milescook/bmwe30-speeduino/README.md

# About

This repo is a collection of diagrams, wiring plans and 3D printable models. The objective is converting a BMW E30 to use Speeduino with a digital dashboard using TS Dash. This uses the original Motronic 1.3 harness to de-risk the conversion.

Disclaimer: Anything you follow here is at your own risk.

Motronic Speeduino

## Wiring
The current running setup uses the stock Motronic 1.3 harness with targeted changes: a replacement injector sub-loom (later harnesses use a sub loom with a connector - see injector wiring for depin tool), TPS rewiring for an E36 variable TPS, AFM plug repurpose, and a relay/ignition module arrangement documented in this repo. I also converted the AFM plug to a generic connector though you could always make an adapter.

You can find a load of shorts and videos on progress here [https://www.youtube.com/cookracinguk](https://www.youtube.com/cookracinguk)

## Contents

These are the key items though take a look through the file list for bits and bobs. There is also an initial custom harness plan, but that is on hold and should be treated as reference only.

- [Motronic pins to Speeduino map](docs/motronic-speeduino-map.md)
- [Cluster Conversion](docs/cluster.md)
- [Speeduino engine data to AiM SOLO 2 DL over CAN](docs/aim-solo-can.md)
- [Ignition module](docs/ignition.md)
- [Intake wiring](docs/intake.md)
- [Injectors & wiring](docs/injector-wiring.md)
- [Main relay](docs/mainrelay.md)
- [TPS wiring](docs/tps.md)
- [Fuel level](docs/fuel-level.md)
- [Lambda](docs/lambda.md)
- [Useful links](docs/links.md)
