milescook/bmwe30-speeduino/docs/new-harness-plans/ecu-pinout.md

# ECU Pinout

Status: ON HOLD reference for a future custom harness. For the current running setup, use `../motronic-speeduino-map.md`.

* 34 pins on 4 rows, 9, 8, 9, 8. Pin number and wire colour (if present)

 [_1YE]  [_2BL]  [_3GR]  [_4WH]  [_5RD]  [_6BK]  [_7YE]  [_8BL]  [_9--]

*  [10--]  [11--]  [12BK]  [13RD]  [14--]  [15--]  [16YE]  [17BL]  
   
   [18--]  [19BL]  [20WH]  [21BL]  [22BK]  [23SG]  [24--]  [25SS]  

 [26RD] [27BK] [28--]  [29--]  [30GR]  [31RD]  [32WH]  [33GR]  [34WH]
  
## Key
* YE - Yellow
* BL - Blue
* GR - Green
* WH - White
* RD - Red
* BK - Black
* SG - Shielded ground
* SS - Shielded signal

## Pins
* 1 Injectors 1 & 6
* 2 Injectors 2 & 5
* 3 Injectors 3 & 4
* 4 Injectors 1 & 6
* 5 Injectors 2 & 5
* 6 Injectors 3 & 4
* 7 Coil packs 1 & 6
* 8 Ground (coolant, iat, lambda)
* 9 -
* 10 - 
* 11 -
* 12 - TPS Ground
* 13 - TPS Live
* 14 -
* 15 -
* 16 - Fuel pump relay
* 17 - Tacho out
* 18 -
* 19 - Coolant temp sensor
* 20 - Inlet temp sensor
* 21 - Lambda sensor
* 22 - TPS signal
* 23 - Crank position sensor ground
* 24 - CPS Shield ground
* 25 - Crank position sensor signal
* 26 - 12v Live
* 27 - 12v Ground
* 28 - 
* 29 - 
* 30 - Spare
* 31 - Oil pressure switch IN
* 32 - Oil pressure switch OUT dash
* 33 - Coil packs 3 & 4
* 34 - Coil packs 2 & 5
