milescook/bmwe30-speeduino/docs/lambda.md

# Lambda
- Car wiring colour - purpose - Motronic pin - Bespoke loom pin no. - Bespoke loom wire colour
- Black - Signal - Motronic pin 28 - 2 - Green
- White - Heater - Fuel pump live relay - 6 - Red
- Gray - Signal Ground - Motronic pin 10 - 5 - Black
- Gray - Heater Ground - ECU Loom ground - 3 - White

## Bespoke lambda loom

We need the ECU to accept the following wiring:

- Pin no. - Colour - Purpose - Connects to
- 1 - Blue - LED diagnostic - Direct to cluster
- 2 - Green - Signal - Car side green Motronic pin 28
- 3 - White - Heater ground - Car side Gray (chassis ground)
- 4 - Brown - Narrow band signal - unused
- 5 - Black - Signal ground - Car side Gray (O2 signal ground motronic pin 10)
- 6 - Red - Fused Live - Car side red

Temp harness
Blue - LED - N/A
red small - o2 sensor gnd - 1 motronic 10
White small - Signal live - 2 motronic 28
green large - fused live - 3 - motronic 23
Yellow - chassis GND - 4 - motronic n/a

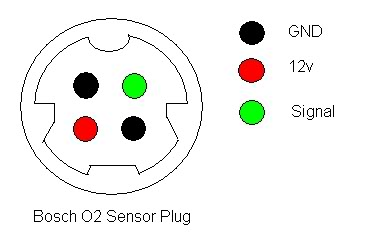
[picture p2: images/O2wiring.jpg]
Car Lambda Connector


# Harness side to o2 side
- Green to white
- Brown to white
- black to gray
- yellow to black
