milescook/bmwe30-speeduino/docs/fuel-level.md

# Fuel level via Speeduino analog input

The fuel sender feeds directly into IDC pin 15. TunerStudio reads it natively and TS Dash can display it as a gauge — no separate microcontroller needed.

## Sender range - readings at the original cluster

- `0 ohms` = full
- `60 ohms` = empty

BMW use a 68 ohm resistor in the cluster, so 128 ohms was empty.
After filling with 15L it read 98 ohms (then ran the engine 10 mins and read 106 — remember the swirl pot would have taken 1 litre).1

Maybe 20 ohms per 15L? I do have dents in my tank.

## Wiring

- Fuel sender one side - White plug pin 4 -> Motronic 32, Arduino pin A9
- Fuel sender other side -> ground
- `1k ohm` resistor from Speeduino pin 13 (idc 16) for 5v to pin Arudino A9

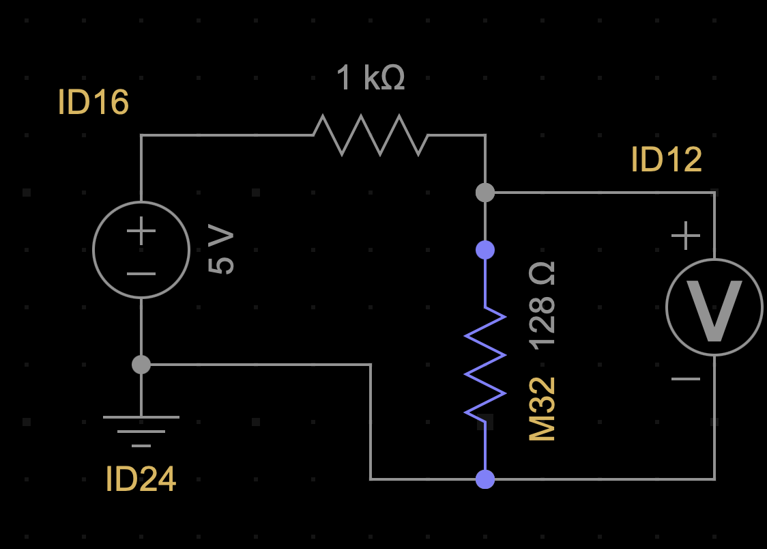
[picture p3: images/fuelcircuit.png]
Fuel-level circuit


Speeduino 40-Pin Harness
       +---------------------
       |                       
       | IDC 16 (5V VREF)-------------------+
       |                                    |
       |                                    |
       |                                  [1k Ω]  Pull-Up Resistor
       |                                    |
       | Pin Analog A9 IDC 12---------------| <--- (Splice Point)
       |                                    |
       | IDC 24 (Sensor GND)                |
       +---------------------    |          |
                                 |          |
                                 v          v Motronic 32 (Econometer)
                            [=== Fuel Sender ===]
                            (Mounted in E30 Tank)

Pin A9 -> Proto 47 -> idc 12 -> Motronic 32

## Why this works

The sender is a variable resistor. The 1km ohm resistor forms a voltage divider with it, producing 0.28–0.57V at IDC pin 14 as the tank goes from full to empty. Speeduino reads this as a standard analog input and TunerStudio exposes it as a loggable channel.

## TunerStudio setup

1. In TunerStudio go to *Tools → Calibrate Analog Inputs*
2. Assign pin 15 (A9) as a generic analog channel (e.g. "Fuel Level")
3. Set the calibration curve: measure the raw ADC value with a known-full and known-empty tank and enter those as the endpoints
4. Add a gauge in TS Dash pointing at that channel

## Calibration

With the 5V reference and 1k ohm divider, expected ADC range:

- Full (68 ohm sender): ~65 / 0.318v
- Empty (128 ohm sender): ~116 / 0.57v

Measure the actual values at known fuel levels and use those for the calibration curve in TunerStudio.

## Steps

- Connect wire A9 -> proto 47 (IDC 12) ✅
- IDC 16 (5v) -> 1k resistor -> IDC 12 ✅
- IDC 12 -> M32
- Dash bridge - C2 4 -> C1 7 (M32)
