milescook/bmwe30-speeduino/docs/idc-numberedpins.md

## Fun fact - 40 pin IDC wire numbers don't correspond to speeduino numbers...

### IDC Ribbon number - Speeduino pin number
* 40 <=> 1
* 39 <=> 40
* 38 <=> 2
* 37 <=> 39
* 36 <=> 3
* 35 <=> 38
* 34 <=> 4
* 33 <=> 37
* 32 <=> 5
* 31 <=> 36
* 30 <=> 6
* 29 <=> 35
* 28 <=> 7
* 27 <=> 34
* 26 <=> 8
* 25 <=> 33
* 24 <=> 9
* 23 <=> 32
* 22 <=> 10
* 21 <=> 31
* 20 <=> 11
* 19 <=> 30
* 18 <=> 12
* 17 <=> 29
* 16 <=> 13
* 15 <=> 28
* 14 <=> 14
* 13 <=> 27
* 12 <=> 15
* 11 <=> 26
* 10 <=> 16
* 9 <=> 25
* 8 <=> 17
* 7 <=> 24
* 6 <=> 18
* 5 <=> 23
* 4 <=> 19
* 3 <=> 22
* 2 <=> 20
* 1 <=> 21
