milescook/bmwe30-speeduino/images/clusterplugs.png

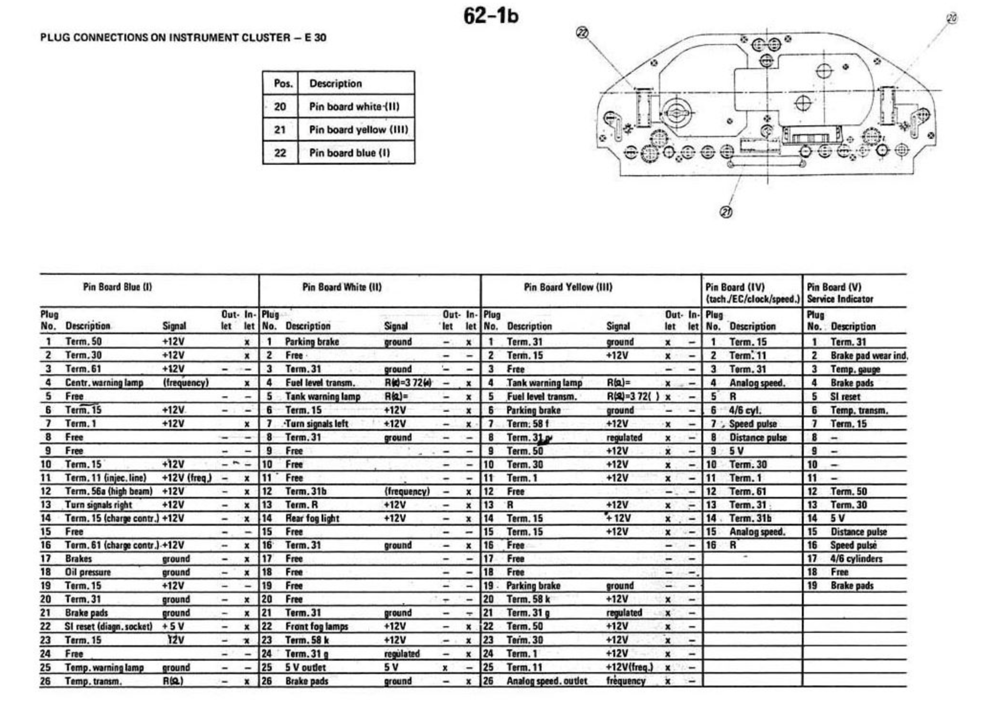
images/clusterplugs.png
