milescook/bmwe30-speeduino/docs/injector-wiring.md

# Injectors

Basically, this wiring needs a change. You can't use the existing E30 M20 injector wiring, because Motronic 1.3 fires in 2 batches of 3. Speeduino doesn't support this, and has 4 injector channels so you have to run it in paired mode, 3 pairs of 2. 

So instead of re-wiring the injector loom, I bought this excellent depin tool (the service was fantastic) and some wiring connectors, from https://falkmfg.com/products/depin-tool so I could re-use the existing plug and make a replacement sub loom.

Injector subloom

## Injectors connector
- Speeduino pin - Speeduino pin description - Description - ECU Pin
- 1 - Injector 1 - Pin 1/2 - Injector 1 - 45
- 2 - Injector 2 - Pin 1/2 - Injector 2 - 16
- 3 - Injector 3 - Pin 1/2 - Injector 3 - 17
- 4 - Injector 3 - Pin 2/2 - Injector 4 - 17
- 39 - Injector 2 - Pin 2/2 - Injector 5 - 16
- 40 - Injector 1 - Pin 2/2 - Injector 6 - 45

## New injector subloom C191 plug wiring

C191 Plug diagram from E30 Zone

- C191 plug pin no | ECU Pin | description
- 1 - 45 - Fuel Injectors 1 & 6
- 2 - Unused Gnd
- 3 - Unused Gnd
- 4 - Unused CLT goes to clocks
- 5 - NA - DME relay (live for Fuel Injectors)
- 6 - 16 - Fuel Injectors 2 & 5
- 7 - 17 - Fuel Injectors 3 & 4

## Injectors

See https://www.gomog.com/allmorgan/InjectorRatesBosch.html

ENGINE BOSCH NUMBER	LBS/HR	CC/MIN	GRAMS	PSI	BAR
2.5  0-280-150-715	14.5	152.4	109.6	43.5	3
2.0  0-280-150-716	12.75	134	96.43	43.5	3
