milescook/bmwe30-speeduino/(commit log)

2026-07-04 tunes, logs etc
    [VE Table.csv]
2026-08-07 Fuel level and cluster wiring work
2026-09-01 Power during cranking
2026-09-26 various tweeaks for 02 sensor stuff
2026-09-30 Config for car speed using crank vr sensor and lambda led status reroute
2026-10-03 updates / clarifications
    [Motronic Speeduino.xlsx]
